monsonite/ChipStick/README.md

# ChipStick
MSP430FR2433 FRAM based miniature dev board
