monsonite/ChipStick/chipstick_2.brd

## EAGLE design chipstick_2.brd (2016-03-22)

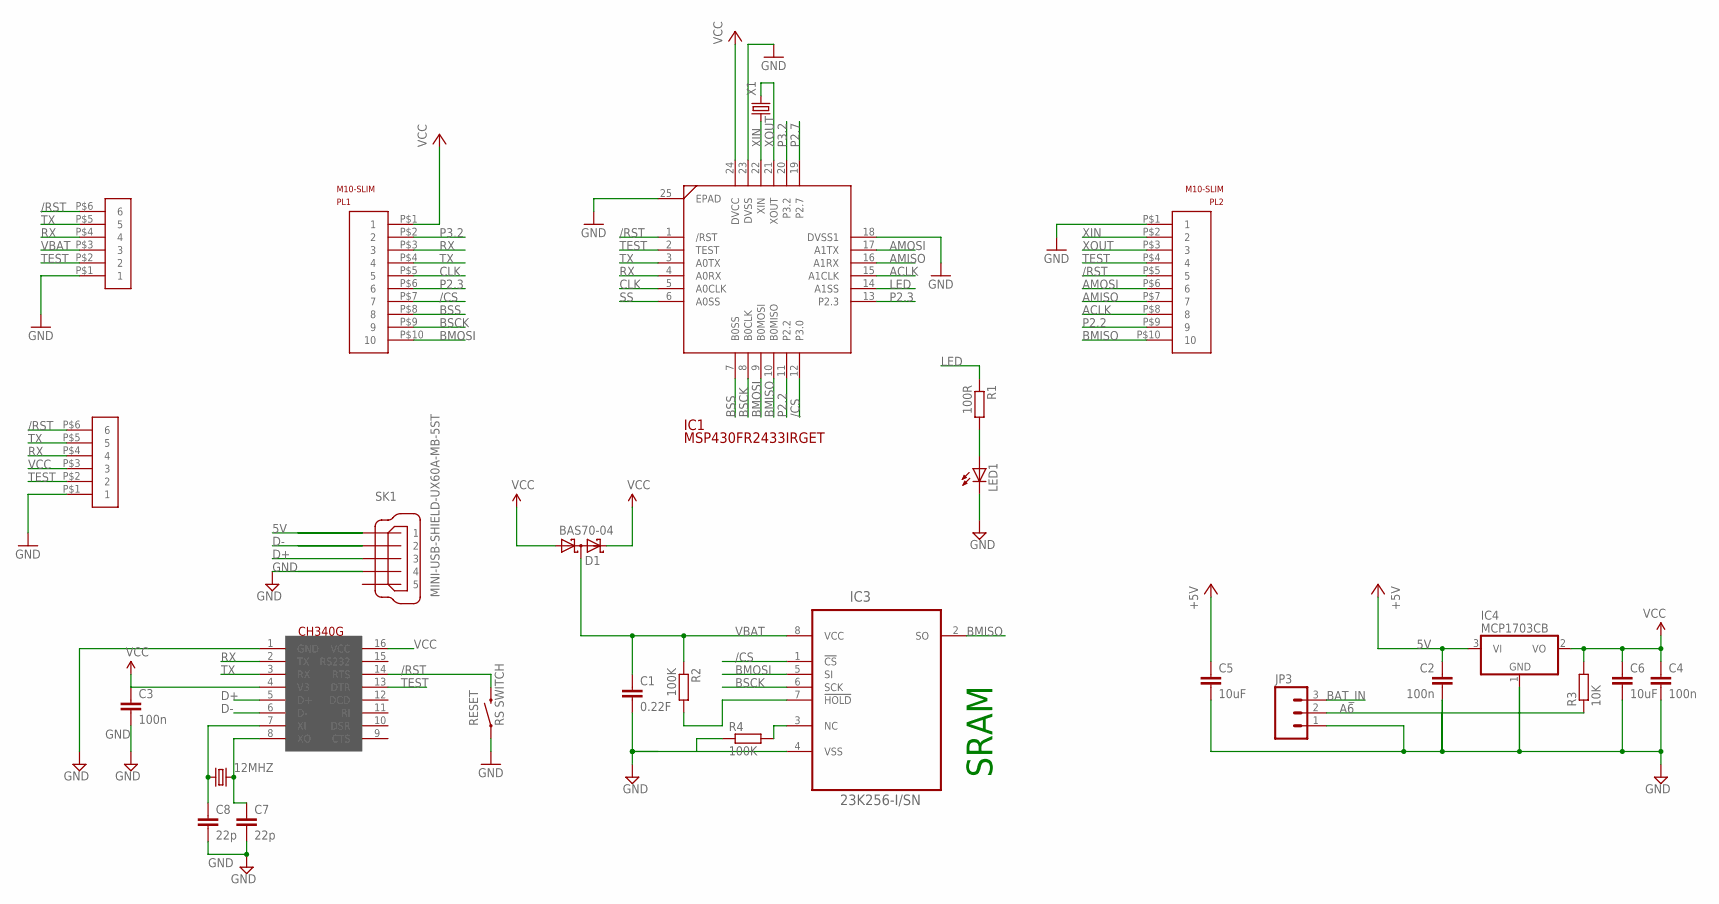
[picture p1: schematic chipstick_2.sch]

Parts:
12MHZ: CRYSTALCTS406; CTS406
C1: 0.22F; C5B5.5
C2, C3, C4: 100n; C0603
C5, C6: 10uF; C0603
C7, C8: 22p; C0603
D1: BAS70-04; SOT23
IC1: MSP430FR2433IRGET; QFN50P400X400X100-25N
IC2: CH340G; SOIC16
IC3: 23K256-I/SN; SOIC127P600X175-8N
IC4: MCP1703CB; SOT23
JP1, JP2: 1X06-1.27MM
JP3: M03POLAR; MOLEX-1X3
LED1: LED0603; LED-0603
PL1, PL2: M10-SLIM
R1: 100R; R0603
R2, R4: 100K; R0402
R3: 10K; R0603
RESET: RS SWITCH; TACTILE-SWITCH-1101NE
SK1: MINI-USB-SHIELD-UX60A-MB-5ST; UX60A-MB-5ST
X1: CRYSTALTC26V; TC26V

Connections:
5V: C2.1, C5.1, IC4.3 (VI), SK1.1
/CS: IC1.12 (P3.0), IC3.1 (!CS), PL1.P$7 (7)
/RST: IC1.1 (/RST), IC2.14 (RTS), JP1.P$6 (6), JP2.P$6 (6), PL2.P$5 (5), RESET.2
A6: JP3.2, R3.1
ACLK: IC1.15 (A1CLK), PL2.P$8 (8)
AMISO: IC1.16 (A1RX), PL2.P$7 (7)
AMOSI: IC1.17 (A1TX), PL2.P$6 (6)
BAT_IN: JP3.3
BMISO: IC1.10 (B0MISO), IC3.2 (SO), PL2.P$10 (10)
BMOSI: IC1.9 (B0MOSI), IC3.5 (SI), PL1.P$10 (10)
BSCK: IC1.8 (B0CLK), IC3.6 (SCK), PL1.P$9 (9)
BSS: IC1.7 (B0SS), PL1.P$8 (8)
CLK: IC1.5 (A0CLK), PL1.P$5 (5)
D+: IC2.5 (D+), SK1.3
D-: IC2.6 (D-), SK1.2
GND: C1.2, C2.2, C3.2, C4.2, C5.2, C6.2, C7.2, C8.2, IC1.18 (DVSS1), IC1.23 (DVSS), IC1.25 (EPAD), IC2.1 (GND), IC3.4 (VSS), IC4.1 (GND), JP1.P$1 (1), JP2.P$1 (1), JP3.1, LED1.C, PL2.P$1 (1), R4.1, RESET.1, SK1.4
LED: IC1.14 (A1SS), R1.1
unnamed: IC3.3 (NC), R4.2
unnamed: 12MHZ.1, C8.1, IC2.7 (XI)
unnamed: 12MHZ.3 (2), C7.1, IC2.8 (XO)
unnamed: LED1.A, R1.2
unnamed: IC3.7 (!HOLD), R2.2
P2.2: IC1.11 (P2.2), PL2.P$9 (9)
P2.3: IC1.13 (P2.3), PL1.P$6 (6)
P2.7: IC1.19 (P2.7)
P3.2: IC1.20 (P3.2), PL1.P$2 (2)
RX: IC1.4 (A0RX), IC2.2 (TX), JP1.P$4 (4), JP2.P$4 (4), PL1.P$3 (3)
SS: IC1.6 (A0SS)
TEST: IC1.2 (TEST), IC2.13 (DTR), JP1.P$2 (2), JP2.P$2 (2), PL2.P$4 (4)
TX: IC1.3 (A0TX), IC2.3 (RX), JP1.P$5 (5), JP2.P$5 (5), PL1.P$4 (4)
VBAT: C1.1, D1.3 (C1A2), IC3.8 (VCC), JP2.P$3 (3), R2.1
VCC: C3.1, C4.1, C6.1, D1.1 (A1), D1.2 (C2), IC1.24 (DVCC), IC2.4 (V3), IC2.16 (VCC), IC4.2 (VO), JP1.P$3 (3), PL1.P$1 (1), R3.2
XIN: IC1.22 (XIN), PL2.P$2 (2), X1.1
XOUT: IC1.21 (XOUT), PL2.P$3 (3), X1.2

Notes on the sheet:
SRAM

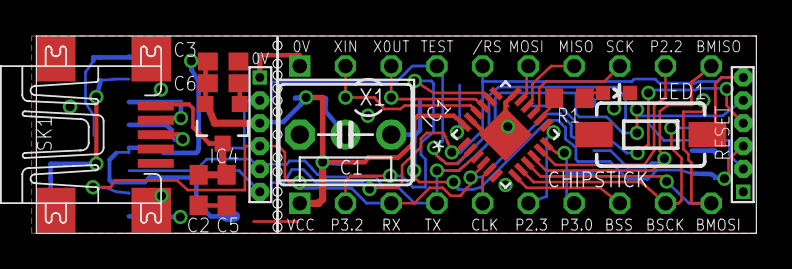
[picture p2: board chipstick_2.brd from above]

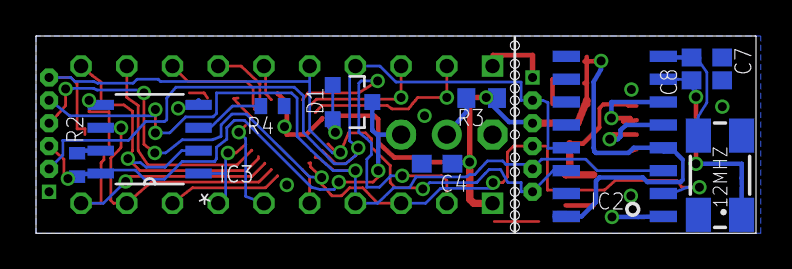
[picture p3: board chipstick_2.brd from below]

Board: 2 copper layers, 40.0 x 11.0 mm, 27 parts (10 on the bottom side), 31 nets.
